antfriend/Chameleon-Eyes/(list of files, drawings)

Other design files:
stepper_drivers_xiao_esp32c3.fzz
